frindo-robot/frindo/3D files/accessories/accessory set.3mf

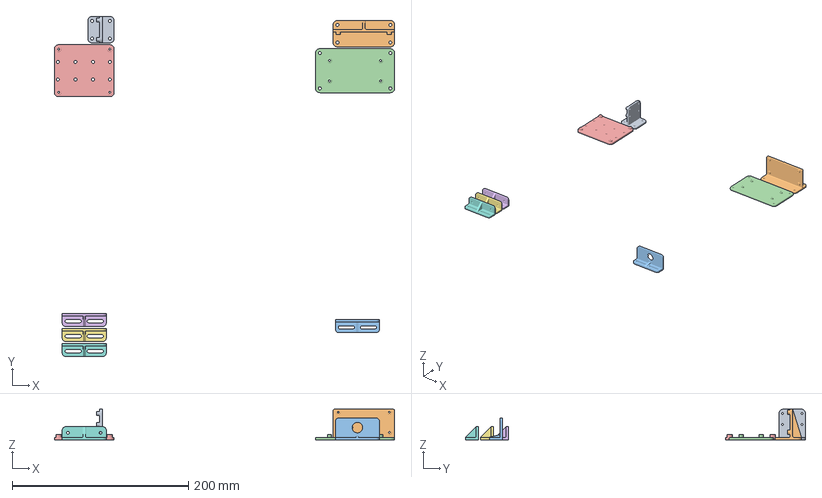
[picture p2: CAD file, 2026-11-09]
3D files/accessories/accessory set.3mf
386.2 x 385.7 x 35.0 mm
Pi Camera Mount.stl
Pi Zero Mount - Vert.stl
Toggle switch bracket.stl
Pi Zero Mount.stl
Pi Mount.stl
Sharp sensor bracket.stl x 3
