frindo-robot/frindo/3D files/chassis/chassis set.3mf

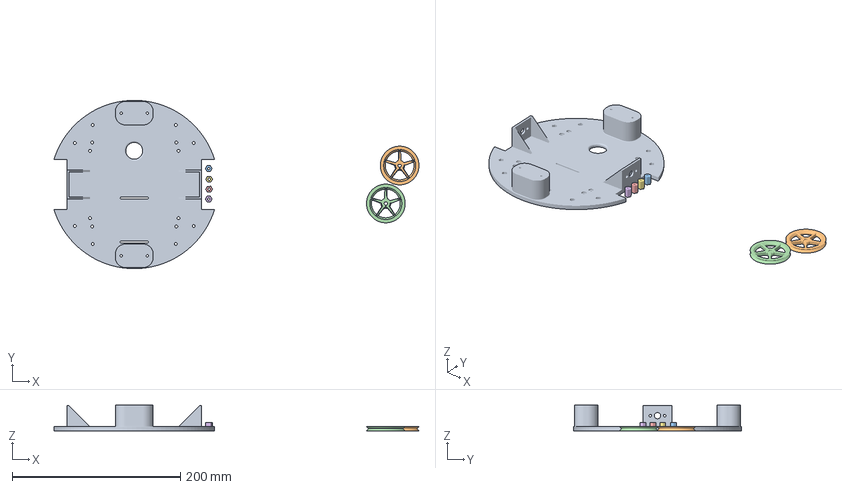
[picture p3: CAD file, 2026-11-09]
3D files/chassis/chassis set.3mf
433.8 x 199.9 x 30.5 mm
3D Printed base.stl
50mm Wheel Hub for O-ring.stl x 2
MC1 stand off.stl x 4
