frindo-robot/frindo/3D files/deck/deck set.3mf

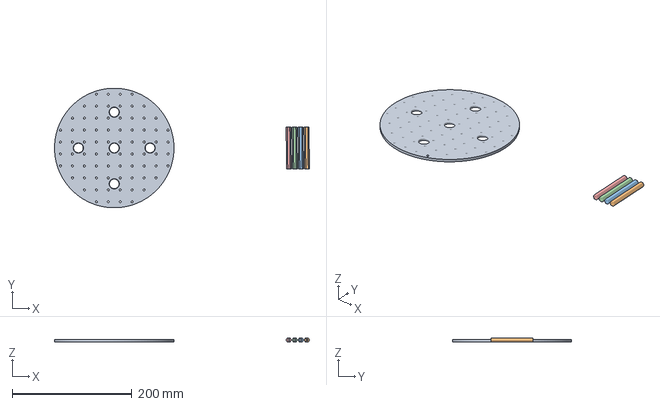
[picture p4: CAD file, 2026-11-09]
3D files/deck/deck set.3mf
426.8 x 200.0 x 7.00 mm
Deck plate.stl
Deck stand off.stl x 4
