frindo-robot/frindo/3D files/accessories/Pi Mount.stl

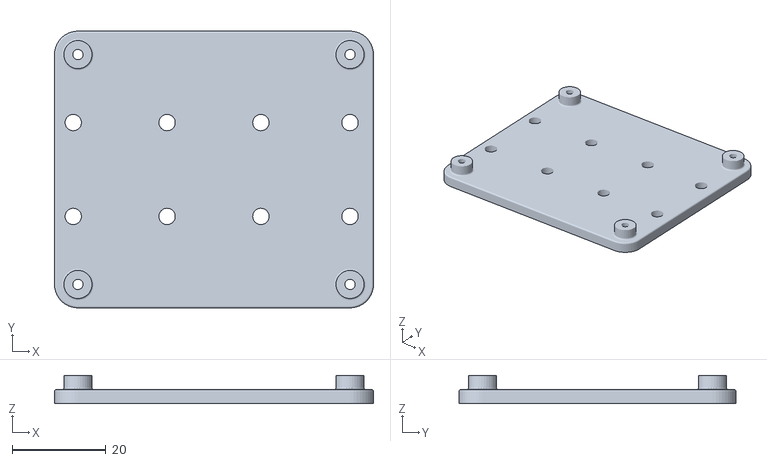
[picture p5: CAD file, 2026-11-09]
3D files/accessories/Pi Mount.stl
68.0 x 59.0 x 6.00
