frindo-robot/frindo/3D files/chassis/MC1 stand off.stl

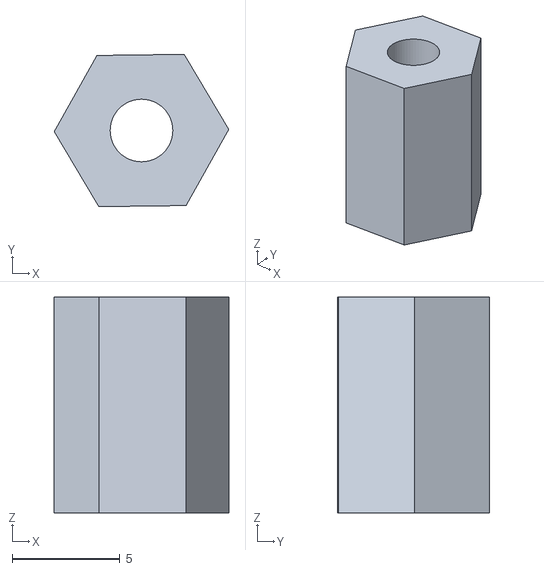
[picture p6: CAD file, 2026-11-09]
3D files/chassis/MC1 stand off.stl
8.08 x 7.05 x 10.0
