frindo-robot/frindo/3D files/deck/Deck plate.stl

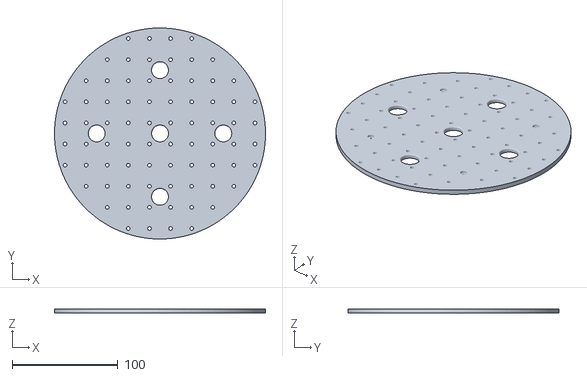
[picture p7: CAD file, 2026-11-09]
3D files/deck/Deck plate.stl
200.0 x 200.0 x 4.00
