frindo-robot/frindo/3D files/accessories/Sharp sensor bracket.stl

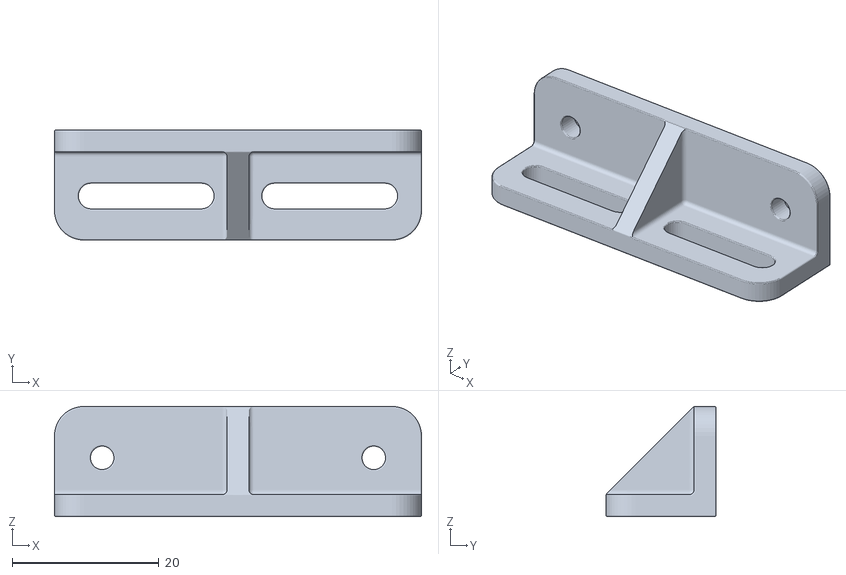
[picture p8: CAD file, 2026-11-09]
3D files/accessories/Sharp sensor bracket.stl
50.0 x 15.0 x 15.0
