frindo-robot/frindo/3D files/chassis/50mm Wheel Hub for O-ring.stl

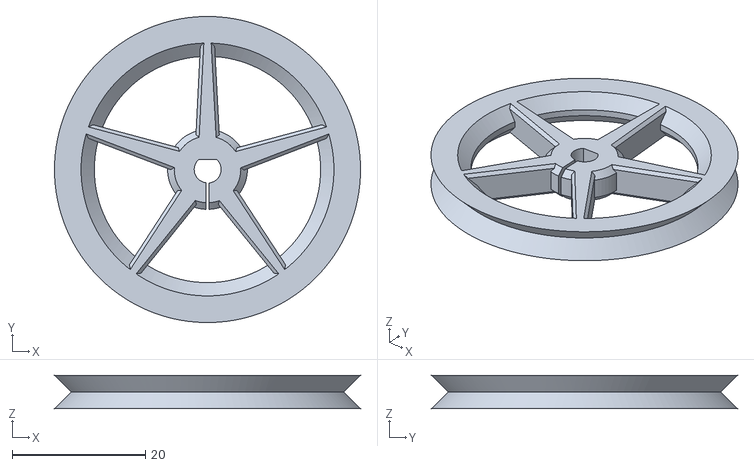
[picture p9: CAD file, 2026-11-09]
3D files/chassis/50mm Wheel Hub for O-ring.stl
46.0 x 46.0 x 5.00
