frindo-robot/frindo/3D files/deck/Deck stand off.stl

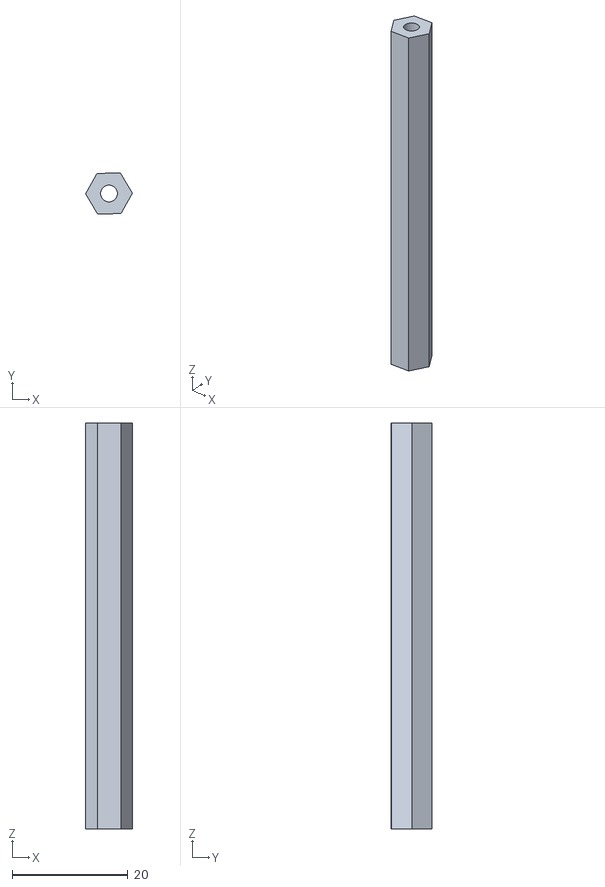
[picture p10: CAD file, 2026-11-09]
3D files/deck/Deck stand off.stl
8.08 x 7.05 x 70.0
