frindo-robot/frindo/3D files/accessories/Pi Camera Mount.stl

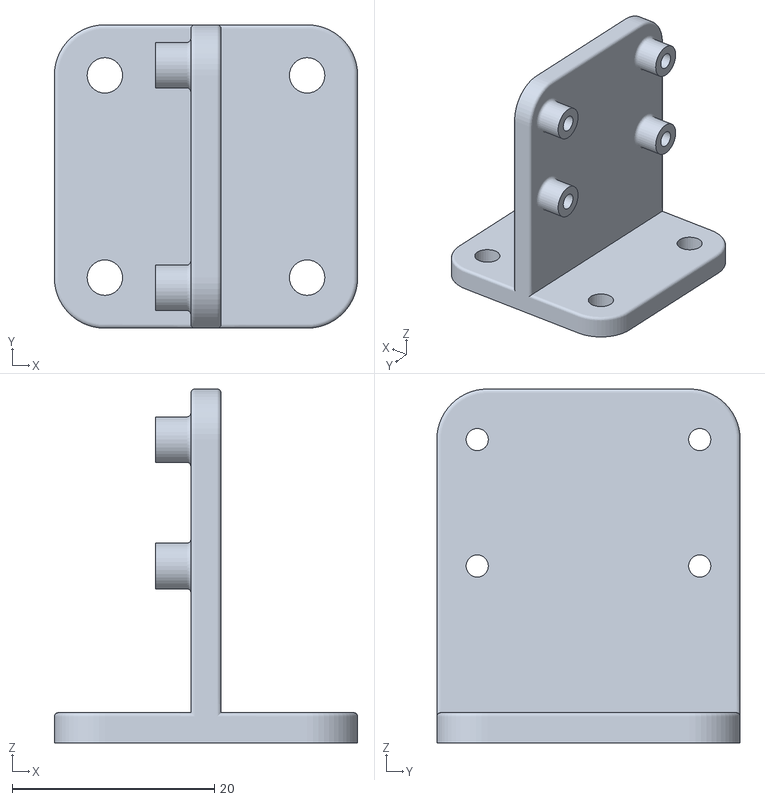
[picture p11: CAD file, 2026-11-09]
3D files/accessories/Pi Camera Mount.stl
30.0 x 30.0 x 35.0
