frindo-robot/frindo/3D files/chassis/3D Printed base.stl

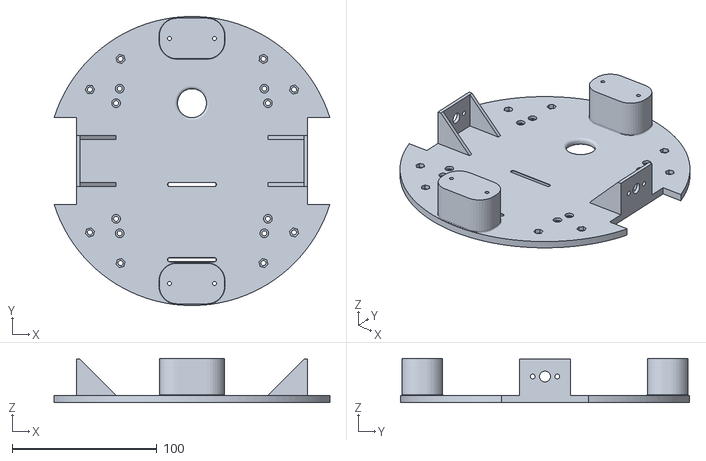
[picture p12: CAD file, 2026-11-09]
3D files/chassis/3D Printed base.stl
190.8 x 199.9 x 30.5
