frindo-robot/frindo/3D files/accessories/Pi Zero Mount - Vert.stl

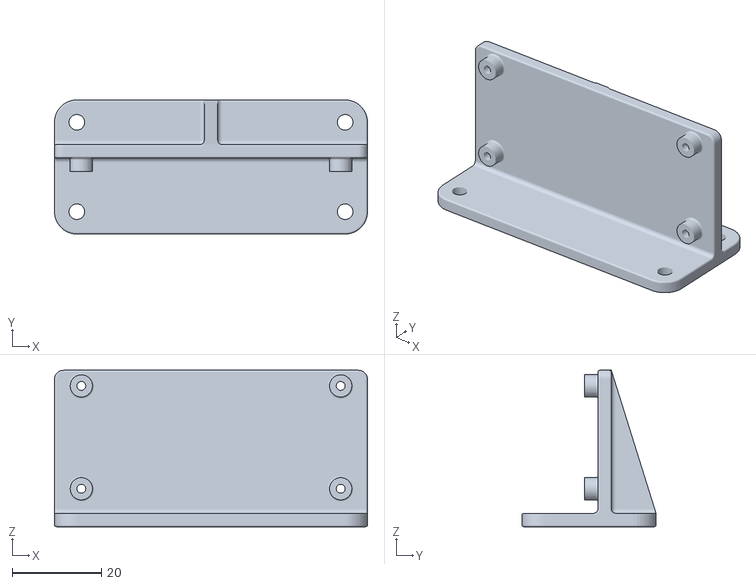
[picture p13: CAD file, 2026-11-09]
3D files/accessories/Pi Zero Mount - Vert.stl
70.0 x 30.0 x 35.0
