frindo-robot/frindo/3D files/accessories/Toggle switch bracket.stl

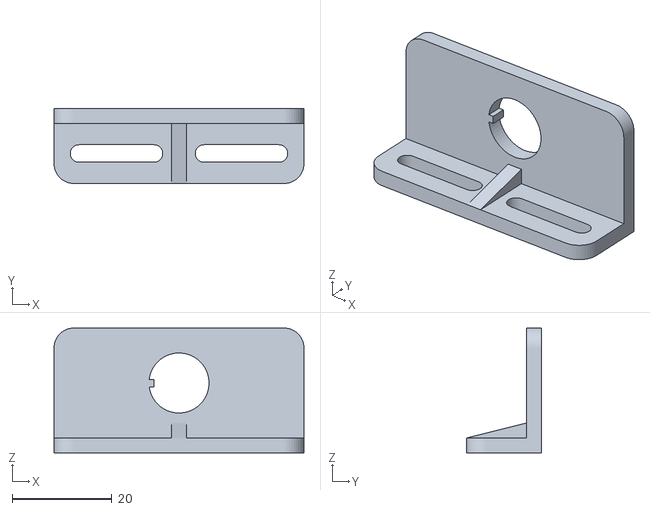
[picture p14: CAD file, 2026-11-09]
3D files/accessories/Toggle switch bracket.stl
50.0 x 15.0 x 25.0
