frindo-robot/frindo/3D files/accessories/Pi Zero Mount.stl

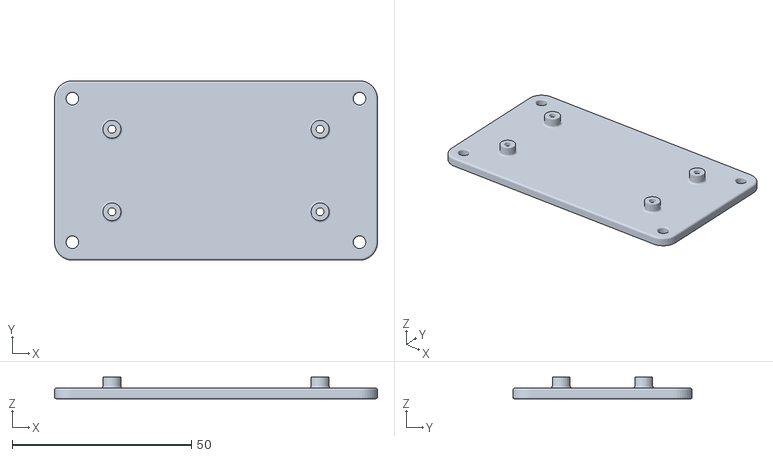
[picture p15: CAD file, 2026-11-09]
3D files/accessories/Pi Zero Mount.stl
90.0 x 50.0 x 6.00
