frindo-robot/frindo/guide-images/6.jpg

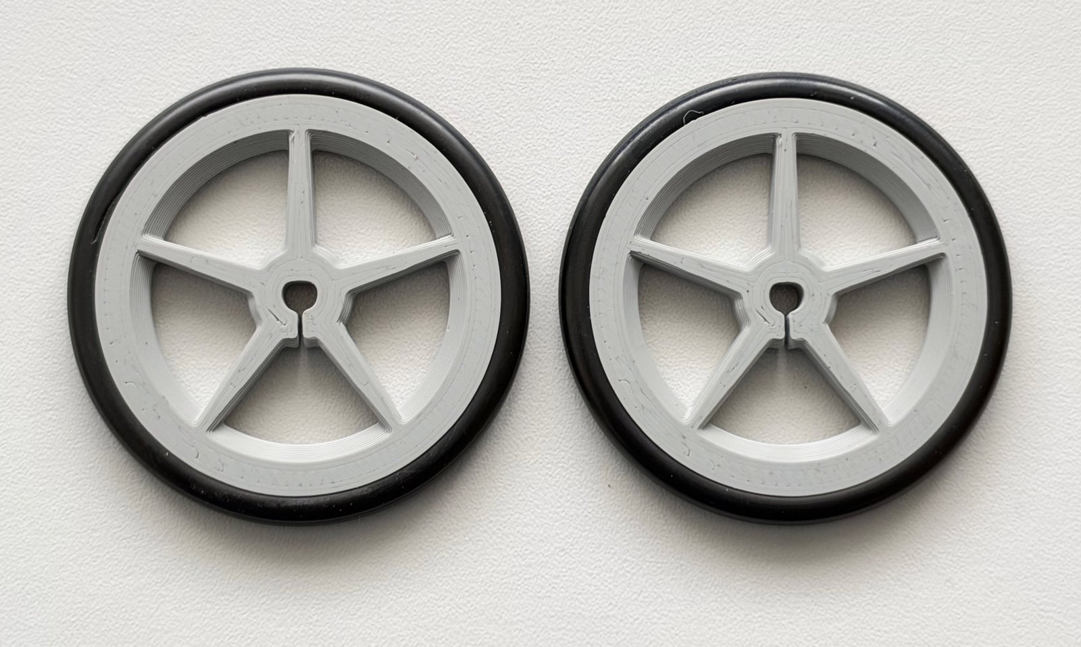
guide-images/6.jpg
