frindo-robot/frindo/(commit log)

2026-11-09 Add README, build guide and STL print files
    Photos and .3mf print sets are held back until they are ready to publish.
    [3D Printed base.stl, 50mm Wheel Hub for O-ring.stl, Deck plate.stl, Deck stand off.stl, MC1 stand off.stl, Pi Camera Mount.stl, Pi Mount.stl, Pi Zero Mount - Vert.stl]
2026-11-09 Add licence, Pi and camera fitting steps, and BOM details
    - LICENSE: CC BY-SA 4.0 for the design files and documentation; the
    image script is MIT, stated in its header
    - Step 15 now covers fitting the Pi, camera, camera cable and both
    MC1 cables, not just the mounts
    - BOM: Pi 5 (4 GB min, 8 GB for SLAM/Nav2), heatsink, Camera Module 3
    Wide, Pi 5 camera cable, microSD; JP1 jumper comes with MC1; USB
    version of MC1; switch is a pre-wired XT60 lead
    - Print settings are the same for every part
    - Battery safety shown as a warning callout
    - README: drop the in-development status, add how to give credit
2026-11-09 Add .3mf print sets and per-plate print estimates
    The three print sets are at 30% infill with supports off for all
    stand-offs, and the Bambu account ID removed. BUILD.md now gives
    Bambu Studio's time and weight per plate rather than per part, and the
    totals for this build are about 7.5 h and 280 g.
    [accessory set.3mf, chassis set.3mf, deck set.3mf]
2026-11-09 Use measured per-part print figures
    Restore the per-part time and weight tables from Jon's 30% infill
    figures, in place of the per-plate slicer estimates. Totals: about
    8 h and 310 g for everything, 6 h and 252 g for the main parts.
2026-11-09 Add motor connectors section
    The Pololu motors end in a 0.1" header that does not fit MC1. New
    section, outside the numbered steps, gives three ways to fit MC1's
    Mini-Fit Jr. and JST XH connectors (crimp new ones, solder on the Cable
    Kit, or buy the Rapid Integration Kit), with the wire-to-pin table.
    Linked from the contents, the BOM, step 5 and step 9.
2026-11-09 Say what the Rapid Integration Kit contains
    Two Pololu #4885 motors with MC1 connectors fitted, so step 14's
    settings apply unchanged, plus the USB-C pigtail for the Pi.
2026-11-10 Allow a 20 to 25 mm battery strap
2026-11-10 Remove the RIK option for now, and give the largest battery size
    The Rapid Integration Kit is a few weeks from sale, so the motor
    connectors section offers options A and B only. The battery row and
    step 7 now give 150 x 50 x 28 mm as the largest pack that fits.
2026-11-10 Add a Pi power cable section for the USB-C pigtail
    Until the RIK is on sale, Pi 5 builders fit a JST VH connector to a
    USB-C pigtail for MC1's J4, by crimping or by soldering on the Cable
    Kit's aux 5 V cable. Pinout from the Rev C datasheet: pin 1 +5 V.
2026-11-10 Link the USB-C data cable and pigtail
2026-11-10 Say the camera software will follow, and fix the Cable Kit contents
2026-11-10 Cable Kit wires match Pololu's colours: join colour to colour
    Adds a note to check the wiring when using another maker's motor.
2026-11-10 Move the connector sections to the end of the guide
    Motor connectors and Pi power cable now follow the software steps, so
    the build starts sooner. Steps 5 and 15 open with a note linking to them.
